ian-musamali/SoC-from-scratch/ascii_doom_soc/clockInfo.txt

-------------------------------------
| Tool Version : Vivado v.2025.2
| Date         : Fri Jul  3 11:27:56 2026
| Host         : ian
| Design       : design_1
| Device       : xc7a100t-csg324-1--
-------------------------------------

For more information on clockInfo.txt clock routing debug file see https://support.xilinx.com/s/article/000035660?language=en_US
