ian-musamali/SoC-from-scratch/ascii_doom_soc/docs/HANDOFF.md

# ASCII Doom SoC — Session Handoff
_Date: 2026-07-03_

## Update (later still same day): Step 16 — Portfolio package DONE

README rewritten: real (tested) Quick Start commands replacing the old TODO
placeholders for FPGA deploy and GDS flow, both Performance tables filled in
with actual numbers (FPGA post-route + ASIC post-PnR from Steps 14/15), and a
real screenshot embedded.

**Found and fixed a real bug while producing the screenshot:** `fonts/font8x8.hex`
(the VGA font ROM's `$readmemh` source) was a placeholder — every one of the
128 glyph slots held the same `0xaa`/`0x55` checkerboard byte pair, not an
actual font. Real hardware would have shown garbage instead of legible
characters on the VGA output; nothing in the existing test suite could have
caught this, since `tb_soc_top.cpp` only checks `char_framebuffer` ASCII byte
values, never the font ROM's pixel content. Fixed with a new generator,
`fonts/gen_font8x8.py`, that rasterizes each printable ASCII glyph (0x20-0x7e)
from DejaVu Sans Mono Bold (downsampled to 8x8, thresholded to 1-bit, shared
baseline for consistent alignment) — zero effect on the sim regression (still
80/80+80/80 PASS) since font content isn't part of any existing check, but the
VGA output would now actually be legible on real hardware. Not yet verified on
physical hardware (bitstream still not reflashed — see Known issues).

Screenshot (`docs/images/screenshot.png`) is a real rasterization of an actual
captured `char_framebuffer` frame — not a mockup — via a new opt-in
`DUMP_FRAME_GRID` env var in `tb_soc_top.cpp` (zero cost/effect unless set) and
`docs/images/gen_screenshot.py`, which renders using the real `font_rom.sv`
bitmap data.

**`.gitignore` gap found and fixed:** OpenLane actually writes its (huge) run
output to `gds/config/runs/`, not `gds/output/` as the existing gitignore rule
assumed — that directory held **7.9 GB** after the Step 15 run (GDS/DEF/ODB
files, many 200MB+ each) and would have been staged in full on the next
`git add .`. Added `gds/config/runs/` to `.gitignore`. `rtl/gpu/luts/*.hex`
(Step 15's LUT tables) and the new `fonts/font8x8.hex` are intentionally *not*
committed either, matching the project's existing convention for `map.hex`/
`firmware.hex` — generated by a script, regenerated before each build, not
checked in. Wired `gen_dda_luts.sh`/`gen_font8x8.py` into the Quick Start /
Quick rebuild reference so a fresh clone doesn't silently break the way the
font ROM did.

---

## Update (later still same day): Step 15 — OpenLane GDS flow for gpu_top DONE

Ran the full OpenLane2/sky130A hardening flow on `gpu_top.sv` (dispatcher + 4×
`dda_core` + collector + MMIO), 20 MHz/50ns target. Full writeup:
`docs/decisions/gpu_top_gds.md`. Short version:

- Found and fixed two real Yosys-incompatibilities in existing (already
  hardware-verified) RTL: `return` statements in `dda_core.sv`'s
  `dist_to_ascii()` function (Yosys doesn't support `return` in functions at
  all), and the `$sin`/`$cos`/`$atan2` LUT-table generation in an `initial`
  block (not synthesizable — Vivado tolerates it, Yosys doesn't implement
  these system functions for synthesis). Fixed the LUTs by freezing the
  already-verified values into `$readmemh`-loaded hex files
  (`rtl/gpu/luts/*.hex`, captured bit-exact via a temporary `$writememh` dump,
  not recomputed from scratch) — same idiom as `map.hex`/`font8x8.hex`
  elsewhere in the project.
- Found and fixed a structural issue: Yosys hard-rejects unpacked-dimension
  module ports. Flattened the per-core array ports on `gpu_dispatcher.sv`,
  `gpu_collector.sv`, and `gpu_top.sv` (and updated `soc_top.sv`'s wiring to
  match, since it instantiates the same `gpu_top.sv`) into packed
  bit-sliced buses. Purely representational — verified via the full sim
  regression, still 80/80 + 80/80 PASS, same cycle count, no new lint warnings.
- **Result: timing closes with +12.48ns worst setup margin across all 10 PVT
  corners (0 setup/hold violations), Magic DRC + KLayout DRC + Netgen LVS all
  PASS, GDSII generated** (`gpu_top.gds`, 263 MB, ~1.72mm × 1.72mm die,
  30.4% utilization).
- Known follow-up, non-blocking: antenna violations (215 pin/192 net) and max
  slew/cap warnings in all corners — standard DFM polish, not correctness
  bugs, not yet addressed.

---

## Update (later same day): dda_core.sv timing fix

The previous handoff below flagged WNS at a razor-thin +0.020ns and asked for the real
critical path to be identified with `report_timing` before touching GPU logic again — and
guessed it was probably `gpu_collector.sv`'s row mux or `wall_top`/`wall_height` fanout. That
guess was wrong. Read the actual timing report and found the real critical path inside
`dda_core.sv`'s per-column ray-direction setup (`player_idx` → sin_table lookup → DSP48E1
multiply → subtract → abs/compare/mux, all landing on `ddx`/`ddy` in one cycle, 17 logic
levels, 15.23ns) — pre-existing logic, not something the wall-height work added, that had
apparently always been the tightest path in the design.

**Fix:** added a `DIR_WAIT` pipeline state between `dda_core.sv`'s `INIT` and `PREP` states to
register the multiply/subtract result one cycle before the abs/compare/mux consumes it. Costs
1 extra cycle per column (invisible at the frame level: ~90-cycle MARCH loop dominates).
Full writeup: `docs/decisions/soc_top.md`, "dda_core.sv direction pipeline split".

**Verified:** Verilator lint clean (no warnings near the edit), sim regression still 80/80 +
80/80 PASS (cycle count 16170→16190, latency-only), full Vivado impl re-run: **WNS
+0.020ns → +0.180ns (9x improvement)**, 0 errors, 0 critical warnings, bitstream regenerated.
New critical path is now the per-core `fpdiv` (wall-height divider), matching what this
handoff's Known Issues section already predicted as the next timing lever — margin is healthy
again so no immediate action needed there.

**Still not reflashed to hardware** — see Known issues below, unchanged.

---

## What was done earlier this session

| Area | Work |
|---|---|
| RTL polish | Verilator lint sweep (verible not installed): 85 → 16 warnings. Added missing `` `timescale `` to 16 files. Fixed `synth_nexys_a7.tcl` (was silently building with the CPU stub, never the real `picorv32.v`). Reviewed and accepted one SYNCASYNCNET warning as standard practice, not a bug. |
| Player input | Wired 5 real Nexys A7 push-buttons through a synchronizer into a new `BUTTONS` register (GPU MMIO offset `0x1C`). Firmware now turns/moves under button control instead of auto-rotating. |
| Wall collision | Firmware checks the destination tile (`tile_is_wall()`) before committing a move, X/Y independently so the player slides along walls. `gen_map_hex.py` now emits `map_data.h` alongside `map.hex` from the same `MAP_STR`, so firmware's collision map can't drift from what's baked into hardware. |
| **Real 3D wall-height rendering** | The GPU previously only ever wrote row 0 of the 80×45 character grid — a one-row shaded strip, not an actual 3D view. Added a per-core `fpdiv` (classic `h = NUM_ROWS/perp_dist` projection); `gpu_collector.sv` now drains each column as ~45 writes (ceiling/wall/floor) instead of one. |
| Backpressure fix | The wall-height change surfaced two real bugs where a fast round could outrun the now much-slower collector and silently drop a column's data (17/80, then 14/80 columns went blank, no error). Root cause: a one-cycle-stale readiness check in `gpu_dispatcher.sv`. Fixed by splitting the wait into two FSM states. Full writeup: `docs/decisions/soc_top.md`. |

Full technical detail, root-causing, and verification methodology for each item lives in
`docs/decisions/soc_top.md` — read that before touching `dda_core.sv`, `gpu_collector.sv`, or
`gpu_dispatcher.sv` again.

### RTL bugs fixed this session
1. **`gpu_dispatcher.sv`/`gpu_collector.sv` backpressure race** — `collector_ready` was checked
   in the same cycle the collector captured the current round's own results, reading a stale
   pre-capture snapshot. Fixed with a new `DRAIN_WAIT` state so the check happens on a strictly
   later cycle. See "Real 3D wall-height rendering" in `docs/decisions/soc_top.md`.
2. **`synth/synth_nexys_a7.tcl`** — globbed `rtl/core/*.sv`, which built the CPU **simulation
   stub** (`picorv32_axi.sv`) instead of the real `picorv32.v`. Brought in line with the
   already-correct `impl_nexys_a7.tcl`.

### Deleted this session
`software/firmware/game_loop.c`, `map.h`, `link.ld`, `start.S` (+ build byproducts) — an
orphaned earlier firmware draft never referenced by the `Makefile`, with a misleading map (an
empty box) that doesn't match the real one actually loaded into hardware.

### New files this session
```
rtl/gpu/gpu_collector.sv (rewritten)   Drains NUM_ROWS writes/column instead of 1
software/firmware/gen_trig_lut.py      Generates trig_lut.h (256-entry Q16.16 sine table)
software/firmware/trig_lut.h           Generated — do not hand-edit
software/firmware/map_data.h           Generated by gen_map_hex.py, firmware's collision copy
```

---

## Current hardware state

**Board:** Nexys A7, last physically programmed with the bitstream from the **2026-06-13**
session (buttons/collision/wall-height auto-rotate era — auto-rotating camera, no 3D, no
input). **Everything from this session (buttons, collision, wall-height, backpressure fix,
dda_core timing fix) is verified in simulation and via a full Vivado place+route run, but has
NOT been reflashed to the physical board.** Re-run the Quick rebuild reference below before
trusting real hardware against anything described here.

**What should be running once reflashed:**
- PicoRV32 @ 65 MHz boots, player starts at (2.5, 2.5). BTNL/BTNR turn, BTNU/BTND move along
  the facing direction with wall collision (slides along walls instead of stopping dead).
- 4-core DDA GPU renders a real pseudo-3D view: each of 80 columns gets a wall-height band
  (near = tall, far = short), not a single shaded row.
- VGA 640×480 @ 60 Hz scans the character grid via font ROM.
- UART prints `frame 0xNNN  cycles=0xNNN` every 64 frames (still unconfirmed on real hardware
  — see Known issues).

**UART:** `/dev/ttyUSB0`, 115200 8N1. `screen` not installed; use
`picocom /dev/ttyUSB0 -b 115200` or `minicom`.

---

## Resource utilization (post-route, 65 MHz, after dda_core timing fix)

| Resource | Used | Available | % |
|---|---|---|---|
| LUTs | 6 745 | 63 400 | 10.64% |
| FFs | 3 491 | 126 800 | 2.75% |
| BRAM tiles | 69.5 | 135 | 51.48% |
| DSP48 | 60 | 240 | 25% |
| MMCM | 1 | 6 | 17% |
| IO | 22 | 210 | 10.5% |

> The 64 RAMB36 tiles are consumed by the 256 KB instruction/data BRAM.
> Reduce `BRAM_WORDS` from 65536 to 16384 (64 KB) to free ~48 tiles if needed.

---

## Known issues / pending work

### Timing margin — RECOVERED, WNS = +0.180 ns (was +0.020 ns, originally +0.420 ns)
Fixed via the `dda_core.sv` `DIR_WAIT` pipeline split described above — see
`docs/decisions/soc_top.md` for the full root-cause writeup. New critical path is the per-core
`fpdiv` (wall-height divider, 14.873ns/11 logic levels) — margin is healthy for now, but this
is the next thing to pipeline if more GPU logic gets added. 100 MHz was never in reach
regardless — the DDA fixed-point arithmetic needs `fpmul`/`fpdiv` pipelining independent of
anything from either session.

### Unconfirmed on real hardware
Buttons, wall collision, and wall-height rendering have **only** been verified in simulation
and via Vivado place+route — none of it has been physically flashed and tested since
2026-06-13. Re-flash (see Quick rebuild reference) and check each independently.

**UART is not "unconfirmed", it's a known stub** — `rtl/core/uart_lite.sv`'s own header says
so explicitly ("Minimal UART stub... Replace with a full UART... for real FPGA use"): it
accepts AXI writes and acks them, but `tx` is hardwired to idle (`assign tx = 1'b1;`) and `rx`
is unused. Firmware's periodic `frame 0xNNN cycles=0xNNN` debug print is real CPU/AXI activity
but never reaches a physical serial line — nothing will appear on `/dev/ttyUSB0` regardless of
wiring. Needs a real UART core (e.g. Xilinx AXI UART Lite) before serial debug output can work.

### `software/ref/raycaster_ref.py` map drift
Its internal map (procedurally generated rooms) doesn't match the real map used everywhere
else (`gen_map_hex.py`'s `MAP_STR`, also embedded directly in `tb_soc_top.cpp`). Noticed while
building wall-height verification, not fixed — the golden reference string in
`tb_soc_top.cpp` is hardcoded and doesn't depend on this script being live, so it wasn't a
blocker this session. Fix before trusting `raycaster_ref.py` as a live oracle again.

---

## Project steps

All 16 originally-scoped steps are now complete. Only unscoped future work
(enemies/shooting, see below) and the Step 15 DFM follow-up remain.

| Step | Description |
|---|---|
| 15 | **DONE (2026-07-03).** OpenLane GDS — GPU block only (`gpu_top.sv` + sub-modules), 20 MHz/50ns target, sky130A. Full writeup: `docs/decisions/gpu_top_gds.md`. Required real RTL fixes for Yosys compatibility (not needed for the FPGA flow): `dda_core.sv`'s `return`-statement function and `$sin`/`$cos` LUT generation (now `$readmemh` from `rtl/gpu/luts/*.hex`), and flattening `gpu_dispatcher.sv`/`gpu_collector.sv`/`gpu_top.sv`'s unpacked-array ports into packed buses (Yosys hard-rejects unpacked ports) — all verified behavior-preserving via the full sim regression (still 80/80+80/80 PASS). Result: **timing closes with +12.48ns worst setup margin, 0 setup/hold violations across all 10 PVT corners; DRC (Magic+KLayout) and LVS all PASS**; GDSII generated (263 MB). Known follow-up (non-blocking DFM polish, not correctness bugs): antenna violations (215 pin/192 net) and max slew/cap warnings in all corners — fixable via diode insertion tuning and buffer insertion respectively, not yet done. |
| 16 | **DONE (2026-07-03).** Portfolio package — README rewritten with real Quick Start commands and both FPGA/ASIC performance tables; real screenshot added (`docs/images/screenshot.png`, rasterized from an actual captured frame via the real font ROM). Found/fixed a placeholder-font bug (see Update above) and a `.gitignore` gap that would have staged 7.9 GB of OpenLane run output. |
| (unscoped) | Enemies/shooting — needs an entity system, sprite billboarding with a per-column depth test against the wall distance each `dda_core` already computes, and a fire-button hit test (BTNC is wired but reserved/unused). Substantial scope increase beyond the original 16-step plan; not broken into steps yet. |

---

## Quick rebuild reference

```bash
cd /home/ian/SoC-from-scratch/ascii_doom_soc

# Firmware (after editing main.c / trig_lut / map data)
make -C software/firmware clean all

# Generated RTL tables (gitignored like map.hex/firmware.hex — regenerate before
# first build or after editing dda_core.sv's LUTs / adding glyphs to the font;
# gen_font8x8.py needs Python 3 + Pillow)
bash rtl/gpu/gen_dda_luts.sh
python3 fonts/gen_font8x8.py

# Simulation regression
rm -rf sim/tb_soc/obj_dir && mkdir -p sim/tb_soc/obj_dir
verilator --cc -Wall --Wno-fatal --public-flat-rw --top-module soc_top -GSIMULATION=1 \
    -Mdir sim/tb_soc/obj_dir \
    rtl/lib/fpdiv.sv rtl/lib/fpmul.sv rtl/lib/font_rom.sv \
    rtl/bus/axi4lite_fabric.sv \
    rtl/vga/vga_sync.sv rtl/vga/char_framebuffer.sv rtl/vga/vga_top.sv \
    rtl/gpu/dda_core.sv rtl/gpu/gpu_dispatcher.sv rtl/gpu/gpu_collector.sv \
    rtl/gpu/gpu_mmio.sv rtl/gpu/gpu_top.sv \
    rtl/dma/axi_dma.sv rtl/core/uart_lite.sv rtl/core/picorv32_axi.sv \
    rtl/soc_top.sv
cd sim/tb_soc/obj_dir && make -f Vsoc_top.mk -s
g++ -std=c++17 -O2 -I . -I /usr/share/verilator/include -I /usr/share/verilator/include/vltstd \
    -c -o tb_soc_top.o ../tb_soc_top.cpp
g++ -std=c++17 -O2 -o Vsoc_top tb_soc_top.o verilated.o verilated_dpi.o verilated_threads.o \
    Vsoc_top__ALL.a -lpthread
cd /home/ian/SoC-from-scratch/ascii_doom_soc && ./sim/tb_soc/obj_dir/Vsoc_top
# Expected: Frame completed in ~16190 cycles
#   PASS: 80/80 wall characters match Python reference
#   PASS: 80/80 wall heights within expected range

# Full FPGA flow: synth + impl + bitstream
vivado -mode batch -source synth/impl_nexys_a7.tcl \
    -log synth/out/impl.log -journal synth/out/impl.jou
# Expected: 0 errors, 0 critical warnings, WNS ~+0.18 ns

# Program board (hw_server must be running)
/tools/2025.2/Vivado/bin/hw_server &
vivado -mode batch -source synth/program_nexys_a7.tcl -nolog -nojournal
```
