ian-musamali/SoC-from-scratch/ascii_doom_soc/docs/decisions/parallel_dda.md

# Parallel DDA Raycasting GPU

## Algorithm

Each DDA core computes one screen column per invocation:

```
ray_angle  = player_angle + atan2(col - 40, 60.0)   // FOV offset per column
ray_dir    = (cos(ray_angle), sin(ray_angle))
delta_dist = (|1/rdx|, |1/rdy|)                     // reciprocal of ray direction
side_dist  = initial accumulator for each axis        // fraction of first cell
DDA march  → step on shorter side until wall hit
perp_dist  = side_dist_axis - delta_dist_axis        // standard perpendicular formula
dist_perp  = perp_dist * cos(atan2(col-40, 60))      // fisheye correction
```

Distance brackets → ASCII bracket: `#%*+=-:.` at thresholds 1.0, 1.5, 2.5, 4.0, 6.0, 9.0, 14.0.

## Pre-computed LUTs (simulation `initial` blocks)

All transcendental functions are evaluated once at elaboration time — no runtime division:

| Table | Size | Contents | Notes |
|---|---|---|---|
| `sin_table[256]` | 256 × 32b | sin(2πk/256) Q16.16 signed | `cos(θ) = sin_table[(idx+64)%256]` |
| `fov_table[80]` | 80 × 32b | atan2(c-40, 60) Q16.16 signed | Column angle offset |
| `fisheye_table[80]` | 80 × 32b | cos(fov_table[c]) Q16.16 unsigned | Fisheye correction factor |
| `fov_sin_table[80]` | 80 × 32b | sin(fov_table[c]) Q16.16 signed | Used in angle addition |
| `ddx_table[80]` | 80 × 32b | \|1/cos(fov_table[c])\| Q16.16 | delta_dist_x (player_angle=0) |
| `ddy_table[80]` | 80 × 32b | \|1/sin(fov_table[c])\| Q16.16 | delta_dist_y (player_angle=0) |

For non-zero `player_angle`, ray direction uses the full angle-addition formula:
```
rdx = cos_p * fov_cos[c] - sin_p * fov_sin[c]
rdy = sin_p * fov_cos[c] + cos_p * fov_sin[c]
```
where `cos_p = sin_table[(player_idx+64)%256]`, `sin_p = sin_table[player_idx]`.

## State Machine (single core)

```
IDLE → INIT → PREP → MAP_WAIT → MARCH (×N steps) → DONE_ST → IDLE
```

| State | Duration | Action |
|---|---|---|
| IDLE | until start | wait for dispatch |
| INIT | 1 cycle | latch player_idx, compute ray_angle |
| PREP | 1 cycle | latch rdx/rdy, ddx/ddy, step signs, initial mx/my |
| MAP_WAIT | 1 cycle | latch sdx_init/sdy_init (first_march flag) |
| MARCH | 1–90 cycles | DDA step: advance shorter axis, read map, check wall |
| DONE_ST | 1 cycle | apply fisheye, bracket lookup, assert done |

Typical latency: ≤95 clock cycles per column (worst-case grazing ray across 64-cell map).

## Parallelism

```
col 0 → core 0 ┐
col 1 → core 1  |
col 2 → core 2  ├── parallel render
col 3 → core 3  |
...              |
col 79 → core 3 ┘
```

Dispatch: `core_id = col_index % NUM_CORES`. The dispatcher fires all cores immediately (no round-trip wait) and the collector harvests results in order.

With 4 cores and 80 columns: 20 rounds × ≤95 cycles/round + overhead ≈ **1900 cycles** worst case.

At 100 MHz: 1900 / 100e6 = 19 µs per frame → theoretical max **52,000 fps** (bottleneck is VGA at 60 Hz).

## Why 4 Cores, Parameterized to 8

| Cores | Columns/round | Frame cycles (worst) | BRAM tiles | Notes |
|---|---|---|---|---|
| 1 | 80 | 7,600 | 1 | Simpler to verify |
| 4 | 20 | 1,900 | 4 | Default — fits Artix-7 comfortably |
| 8 | 10 | 950 | 8 | Parameter `NUM_CORES=8` — uses 8× BRAM |

4 cores is the default: comfortable timing margin at 100 MHz, low BRAM usage, 20× over VGA deadline.

## Simulation Results

Player position (2.5, 2.5), angle 0 (facing east):

```
REF: ****++++++++++++++========----::::.................::::::---------============++
RTL: ****++++++++++++++========----::::.................::::::---------============++
```

**80/80 columns PASS — exact bit-for-bit match with Python reference.**

Key LUT precision notes:
- `fisheye_table` uses ceiling rounding for cols 0–79 (except col 25 which uses floor to match Python float64 boundary behavior at the 6.0 threshold)
- `ddy_table` uses round-half-up to match Python float64 accumulation
