ian-musamali/SoC-from-scratch/ascii_doom_soc/tight_setup_hold_pins.txt

+====================+===================+===============================================+
| Launch Setup Clock | Launch Hold Clock | Pin                                           |
+====================+===================+===============================================+
| sys_clk_raw        | sys_clk_raw       | u_soc/u_gpu/gen_cores[3].u_core/sdy_reg[29]/D |
| sys_clk_raw        | sys_clk_raw       | u_soc/u_gpu/gen_cores[3].u_core/sdy_reg[31]/D |
+--------------------+-------------------+-----------------------------------------------+
