ian-musamali/SoC-from-scratch/ascii_doom_soc/software/firmware/gen_map_hex.py

#!/usr/bin/env python3
"""Generate map.hex ($readmemh, for the hardware map_bram) and map_data.h (a C
array with identical contents, for firmware-side collision checks) from the
same MAP_STR layout — single source of truth so the two can't drift.
Each cell is one byte: 0x00 = floor, 0x01 = wall.
The map is 64x64 = 4096 bytes, row-major (index = row*64 + col), matching
dda_core.sv's `map_read_addr = my*64 + mx` addressing.
"""
_WALL = "1000000000000000000000000000000000000000100000000000000000001001"
_OPEN = "1000000000000000000000000000000000000000000000000000000000000001"

MAP_STR = [
    "1111111111111111111111111111111111111111111111111111111111111111",  # 0
    "1000000000000000000000000000000000000000000000000000000000000001",  # 1
    "1000000000000000000000000000000000000000000000000000000000000001",  # 2
    "1000000000000000000000000000000000000000000000000000000000000001",  # 3
    "1000000000000000000000000000000000000000000000000000000000000001",  # 4
    "1000011111111111111111111100001111111111111111111110000000000001",  # 5
    "1000010000000000000000000100001000000000000000000010000000000001",  # 6
    "1000010000000000000000000100001000000000000000000010000000000001",  # 7
    "1000010000000000000000000100001000000000000111110010000000000001",  # 8
    "1000010000000000000000000100001000000000000010100010000000000001",  # 9
    "1000010000000000000000000000000000000000000010100000000000000001",  # 10
    "1000010000000000000000000100001000000000000010100010000000000001",  # 11
    "1000010000000000000000000100001000000000000010100010000000000001",  # 12
    "1000010000000000000000000100001000000000000010100010000000000001",  # 13
    "1000010000000000000000000100001000000000000010100010000000000001",  # 14
    "1000011111111111111111111100001111111111111111111110000000000001",  # 15
    "1000000000000000000000000000000000000000000010100000000000000001",  # 16
    "1000000000000000000000000000000000000000000010100000000000000001",  # 17
    "1000000000000000000000000000000000000000111110111111111111111001",  # 18
    _WALL, _WALL, _WALL, _WALL, _WALL, _WALL, _WALL, _WALL, _WALL, _WALL, _WALL,  # 19-29
    "1000000000000000000000000000000000000000111111111111111111111001",  # 30
    _OPEN, _OPEN, _OPEN, _OPEN, _OPEN, _OPEN, _OPEN, _OPEN,  # 31-38
    _OPEN, _OPEN, _OPEN, _OPEN, _OPEN, _OPEN, _OPEN, _OPEN,  # 39-46
    _OPEN, _OPEN, _OPEN, _OPEN, _OPEN, _OPEN, _OPEN, _OPEN,  # 47-54
    _OPEN, _OPEN, _OPEN, _OPEN, _OPEN, _OPEN, _OPEN, _OPEN,  # 55-62
    "1111111111111111111111111111111111111111111111111111111111111111",  # 63
]

assert len(MAP_STR) == 64, f"Expected 64 rows, got {len(MAP_STR)}"
for i, r in enumerate(MAP_STR):
    assert len(r) == 64, f"Row {i} has {len(r)} cols"

with open("map.hex", "w") as f:
    for row in MAP_STR:
        for ch in row:
            f.write("01\n" if ch == '1' else "00\n")

print(f"Wrote map.hex ({64*64} entries)")

with open("map_data.h", "w") as f:
    f.write("#pragma once\n")
    f.write("#include <stdint.h>\n\n")
    f.write("// Row-major, index = row*MAP_SIZE + col, matching dda_core.sv's\n")
    f.write("// map_read_addr = my*64 + mx and map.hex's byte order.\n")
    f.write("// Generated by gen_map_hex.py from the same MAP_STR — do not hand-edit.\n")
    f.write("#define MAP_SIZE 64\n\n")
    f.write("static const uint8_t game_map[MAP_SIZE * MAP_SIZE] = {\n")
    for row in MAP_STR:
        f.write("    " + ",".join(row) + ",\n")
    f.write("};\n")

print("Wrote map_data.h (64x64 entries)")
