ian-musamali/SoC-from-scratch/(commit log)

2026-07-03 Add player input, wall collision, and real 3D wall-height rendering
    RTL polish: Verilator lint sweep (85->16 warnings), missing timescale
    directives, fixed synth_nexys_a7.tcl building the CPU stub instead of
    the real picorv32.v.
    Player input: wired 5 Nexys A7 buttons through a synchronizer into a
    new GPU MMIO BUTTONS register; firmware now turns/moves under button
    control instead of auto-rotating, with wall collision (slide-along)
    checked against a firmware-side copy of the real map.
    Real 3D rendering: the GPU previously only ever wrote row 0 of the
    80x45 character grid (a one-row shaded strip, not an actual 3D view).
    Added a per-core fpdiv computing a classic wall-height projection;
    gpu_c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
    [axi4lite_fabric.sv, axi_dma.sv, char_framebuffer.sv, dda_core.sv, fpga_top.sv, gen_map_hex.py, gen_trig_lut.py, gpu_collector.sv]
2026-07-04 Add TinyNPU: FPGA neural processing unit, phases 1-8 complete
    Self-contained 4-class image classifier (32x32 RGB) built around a 64-lane
    int8 MAC array with int32 accumulation and saturation.
    - rtl/: mac_array (4-stage pipelined DSP products + split adder tree),
    conv_engine (3x3 window-walker: padding, stride, multi-channel, multi-pass
    acc_in chaining, int8 requant), npu_core (layer-descriptor sequencing FSM),
    tinynpu_top FPGA wrapper (button -> load -> infer -> argmax -> LEDs) with
    BRAM-backed memories
    - model/: bit-exact Python golden models + seeded vector/memory generators;
    every expectation in verification comes from these files, never re-derived
    in SV
    - uvm/: three UVM 1.2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
2026-07-20 Add layperson setup-and-play guide to README
    Plain-language section covering the parts list, one-time tool install,
    copy-paste build commands, board programming, and button controls.
